Old-Nick-99/Simplified_CheapFOCer/Hawk.png

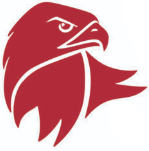
Hawk.png
